nicotakuya/diyfcmultitap/fc_multitap2p_schematics.png

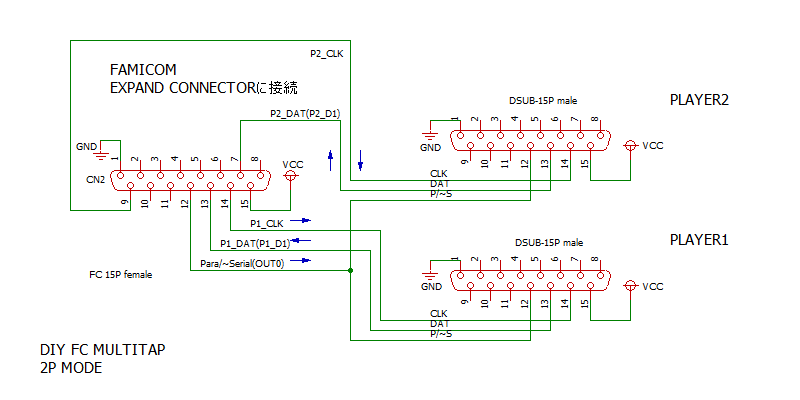
fc_multitap2p_schematics.png
