nicotakuya/diyfcmultitap/fc_multitap4p_schematics.png

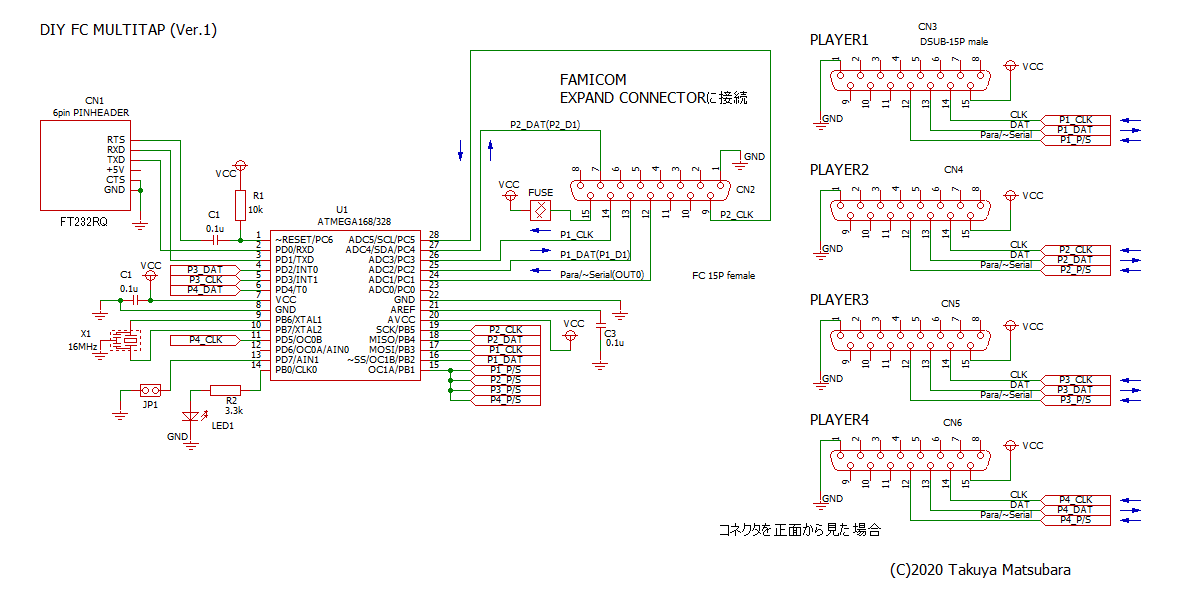
fc_multitap4p_schematics.png
