nicotakuya/diyfcmultitap/fc_multitap4p_timing.png

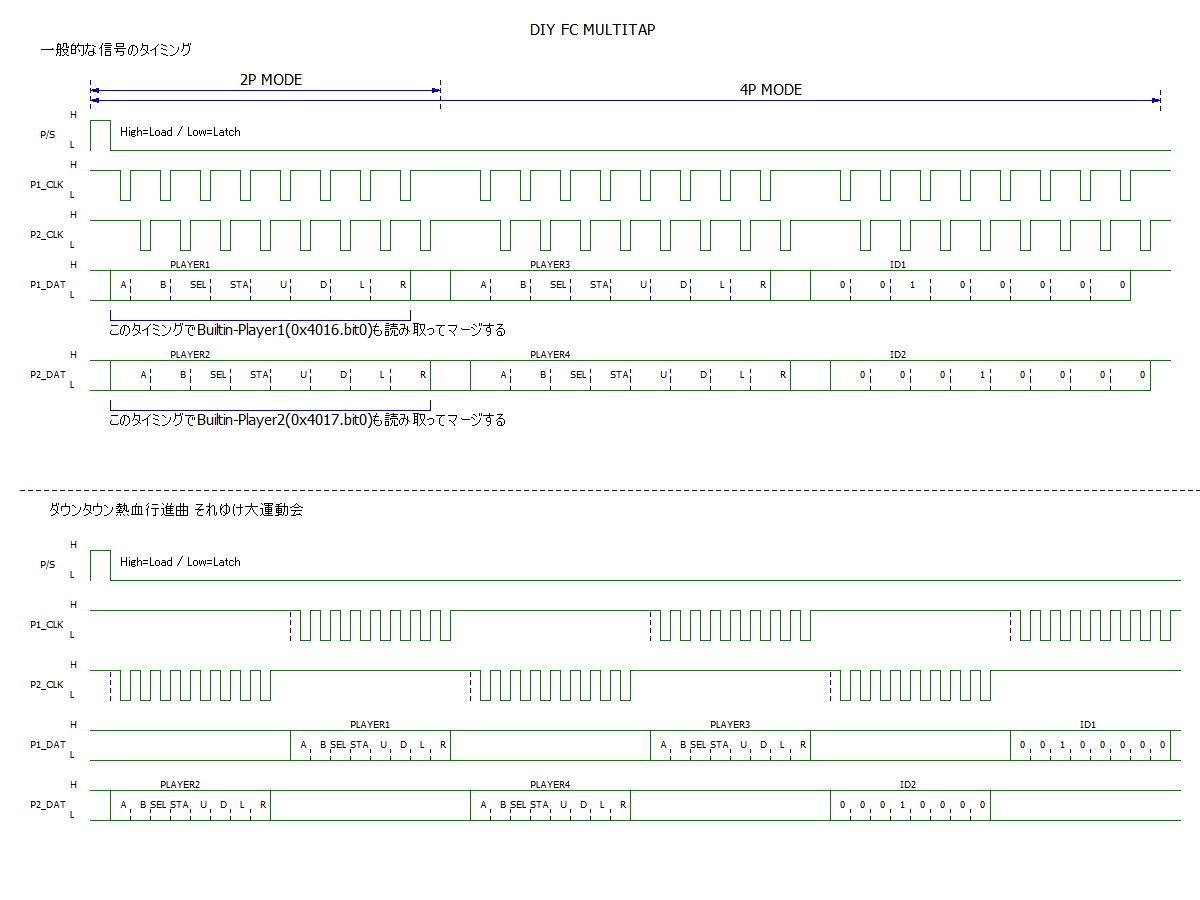
fc_multitap4p_timing.png
